zdid/opi4pro-3dbox/README.md

# opi4pro-3dbox

Boîtier imprimable en 3D pour l'Orange Pi 4 Pro.

Projet en démarrage : les fichiers de conception (SCAD, STL) et les notes seront ajoutés ici.
