zdid/opi4pro-3dbox/freecad/boitier_opi4pro.FCStd

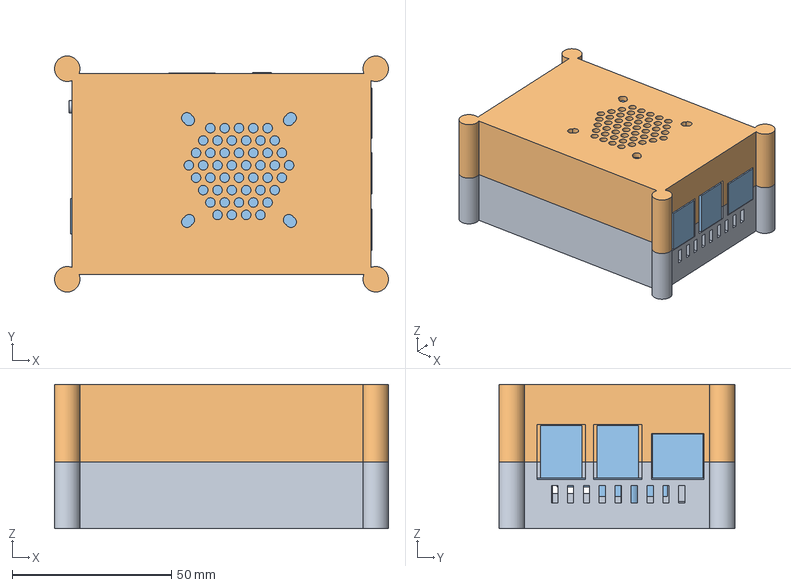
[picture p1: CAD file, 2026-10-16]
freecad/boitier_opi4pro.FCStd
105.0 x 74.2 x 45.4 mm
Socle
Capot
Maquette_carte
