zdid/opi4pro-3dbox/freecad/socle.stl

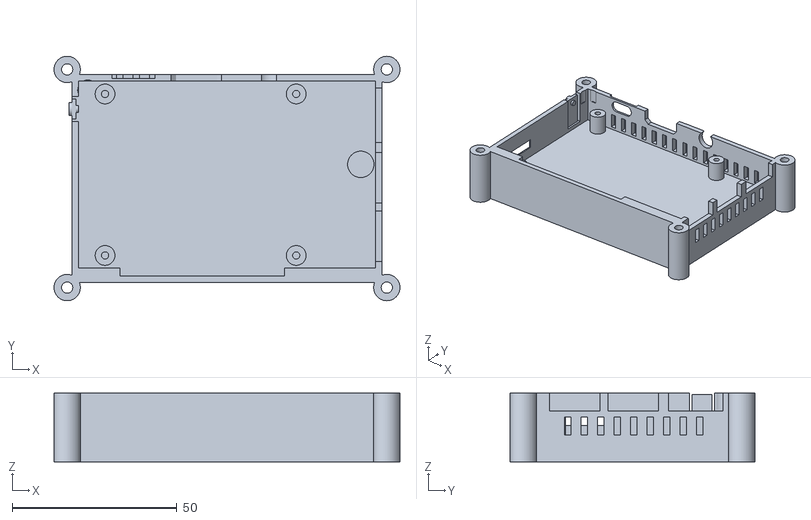
[picture p2: CAD file, 2026-10-16]
freecad/socle.stl
105.0 x 74.2 x 20.9
