zdid/opi4pro-3dbox/freecad/capot.stl

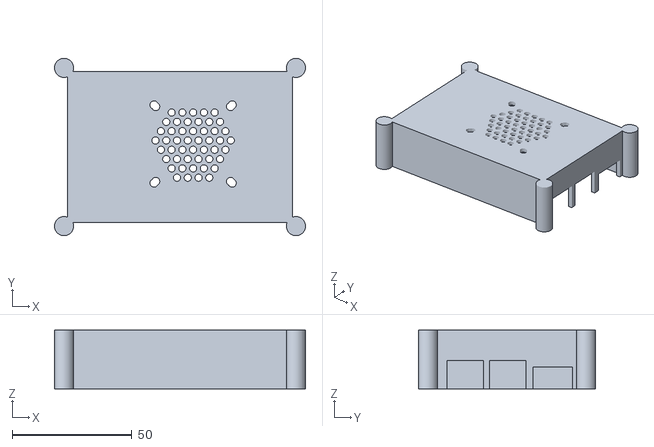
[picture p3: CAD file, 2026-10-05]
freecad/capot.stl
105.0 x 74.2 x 24.5
