zdid/opi4pro-3dbox/(commit log)

2026-10-05 Cahier des charges du boîtier Orange Pi 4 Pro (brouillon v0.10)
    Données de la carte (manuel et mesures), exigences de contenu, de
    refroidissement (ventilateur 40 mm, SSD M.2 2280 à l'arrière), raccordement
    du ventilateur au 40 broches, antenne en deux options, points ouverts.
    Claude-Session: https://claude.ai/code/session_01T9R5g9ncDWJ39MyXaqnC64
2026-10-05 Cahier des charges : ventilateur 2 ou 4 fils, avertissement 3,3 V / 5 V, dissipateurs 6 mm (v0.13)
    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
2026-10-05 Cahier des charges v0.36 : cotes des prises, socle, microSD, micro, bouton POWER, ventilateur 40x10
    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
2026-10-05 Cahier des charges v0.39 : socle, vis, fixation murale, ventilateur dans le capot, FreeCAD
    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
2026-10-05 Boîtier v1 : macro FreeCAD (socle, capot, maquette), FCStd et STL
    Macro paramétrique construite d'après le cahier des charges v0.39 :
    carte encastrée et vissée dans le socle, double fond avec trou de serrure,
    poussoir souple du bouton POWER, ventilateur 40x10 sous le capot,
    couloir d'air vers le SSD et fentes basses. Testée avec FreeCAD 1.1.3
    (solides valides, aucune collision avec la maquette de la carte).
    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
    [boitier_opi4pro.FCStd, capot.stl, socle.stl]
2026-10-05 Boîtier v1.1 : bouton POWER (sommet à 4,8 mm, Ø 2,2), USB_Y0 = 2,5 mm, plan de joint relevé
    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
    [boitier_opi4pro.FCStd, capot.stl, socle.stl]
2026-10-05 Boîtier v1.2 : position réelle du SSD et plot de calage sous le support de vis M.2
    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
    [boitier_opi4pro.FCStd, socle.stl]
2026-10-05 Boîtier v1.3 : cale du SSD au droit du support de vis (Ø 5 au contact, 87,6 mm)
    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
    [boitier_opi4pro.FCStd, socle.stl]
2026-10-05 Boîtier v1.4 : cale du SSD recalée en largeur (33,4 mm du côté 40 broches)
    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
    [boitier_opi4pro.FCStd, socle.stl]
2026-10-05 Boîtier v1.5 : cale du SSD creusée pour le téton du support à épaulement
    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
    [boitier_opi4pro.FCStd, socle.stl]
2026-10-05 Boîtier v1.6 : cale du SSD Ø 6 au contact (surface de la tête de vis)
    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
    [boitier_opi4pro.FCStd, socle.stl]
2026-10-05 Boîtier v1.7 : téton du support au ras du SSD, logement de la cale réduit à 0,5 mm
    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
    [boitier_opi4pro.FCStd, socle.stl]
2026-10-05 Documentation : toutes les variables d'ajustement commentées et listées, points ouverts à jour
    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
    [boitier_opi4pro.FCStd]
2026-10-05 Boîtier v1.8 : une fenêtre par prise USB / RJ45, avec pattes entre les prises ; où trouver les paramètres
    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
    [boitier_opi4pro.FCStd, capot.stl, socle.stl]
2026-10-05 Boîtier v1.9 : ouvertures à la forme des prises (USB-C oblong, HDMI à coins coupés, jack rond)
    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
    [boitier_opi4pro.FCStd, capot.stl, socle.stl]
2026-10-05 CLAUDE.md pour reprendre le projet dans une nouvelle session, script de vérification
    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
2026-10-16 Relecture : documentation alignée sur la v1, épaisseur de la languette POWER en paramètre
    - Cahier des charges v0.48 : R4 décrit la solution réelle (couloir + fentes basses),
    C6 donne les tailles de fiches retenues, C7 Ø 2,1 à 2,2, hauteur réelle du ventilateur.
    - Macro : LANGUETTE_EP (1,2 mm, géométrie inchangée), commentaire des trous mis à jour.
    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
2026-10-16 Boîtier v1.10 : cale du SSD supprimée, logement pour la vis du SSD (9 mm sous la carte)
    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
2026-10-16 Matière : PETG à la place du PLA (cahier des charges v0.50, documentation)
    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
2026-10-16 LISEZMOI : réglages Cura de départ pour imprimer le boîtier en PETG sur Ender 5
    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
2026-10-16 LISEZMOI : tour de température PETG (principe, lecture, mise en place dans Cura)
    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
2026-10-16 LISEZMOI : référence au cahier des charges v0.50
    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
